Whiplash-Robotics/Whiplash-Aimbot/README.md

# Whiplash - real life aim machine

<div align="center">



</div>

**Status:** Very heavily under construction 🚧  
**Start Date:** December 1, 2024
**Last Updated:** March 31, 2025

## **Our Vision**

This project is an ambitious undertaking to create a _real-life aim machine_—a physical device that moves a mouse to click on targets as quickly and accurately as possible. We aim to push the boundaries of hardware, software, and real-time interaction with a custom-built system.

### **Goals**

1. **Develop Our Own Game**  
   A game designed specifically to challenge and evaluate the capabilities of the aim machine.
2. **Assemble Custom Hardware**  
   Build a physical setup capable of precise and rapid movements to replicate human mouse control.
3. **Implement Computer Vision**  
   Create algorithms to detect and track game elements in real-time.
4. **Write Control Software**  
   Design software to integrate the hardware, computer vision, and game logic seamlessly.

### **Current Progress**

The project is in its very early stages, with planning, research, and initial prototyping underway.

## **Contributors**

A huge thanks to everyone involved in this project!

- [Ryan Zhu](https://github.com/Juno9170) – Project lead &rarr; all-around wizard 🧙‍♂️
- [Daniel Lu](https://github.com/FinityFly) - Computer vision &rarr; hehehehaw 🐷
- [Uros Petrovic](https://github.com/Crooder1) – R&D hardware &rarr; super genius 🧠
- [Puneet Singh](https://github.com/punz1738) – 3D Design & Software developer &rarr; the spearhead 💪
- [Edward Zhang](https://github.com/edwardzhang00) - Game Developer, R&D Software &rarr; our backbone 🪨

## Learnings

For more detailed learnings, refer to [LEARNINGS.md](LEARNINGS.md).

## Tech Stack

- Language: Placeholder for programming language
- Framework: Fumadocs in Next for Documentation, Placeholder for framework
- Tools: Placeholder for tools
- Libraries: Placeholder for libraries
- Other: Placeholder for other technologies
