Whiplash-Robotics/Whiplash-Aimbot/documentation/content/docs/assets/OBJs.mdx

---
title: OBJ Files
description: Downloadable OBJ files for the project
---

## OBJ Files

Below is a list of downloadable OBJ files for various components of the project:

<ul>
  <li><a href="path/to/belt-tensioner.obj" download>Belt Tensioner</a></li>
  <li><a href="path/to/pulley.obj" download>Pulley</a></li>
  <li><a href="path/to/frame.obj" download>Frame</a></li>
</ul>
