Whiplash-Robotics/Whiplash-Aimbot/documentation/content/docs/assets/STLs.mdx

---
title: STL Files
description: Downloadable STL files for the project
---

## STL Files

Below is a list of downloadable STL files for various components of the project:

<ul>
  <li><a href="path/to/belt-tensioner.stl" download>Belt Tensioner</a></li>
  <li><a href="path/to/pulley.stl" download>Pulley</a></li>
  <li><a href="path/to/frame.stl" download>Frame</a></li>
</ul>
