Whiplash-Robotics/Whiplash-Aimbot/control/outputs/graph/out_20250601_153231_rpm_graph.png

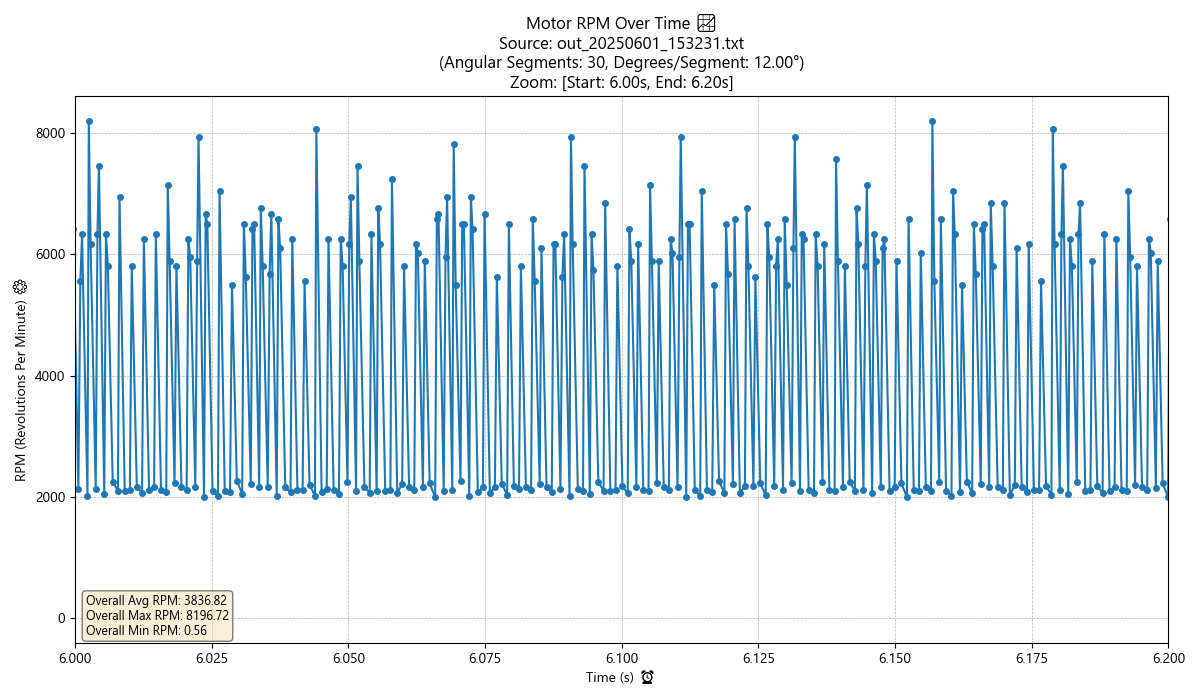
control/outputs/graph/out_20250601_153231_rpm_graph.png
