Whiplash-Robotics/Whiplash-Aimbot/control/outputs/graph/out_20250601_154959_rpm_graph.png

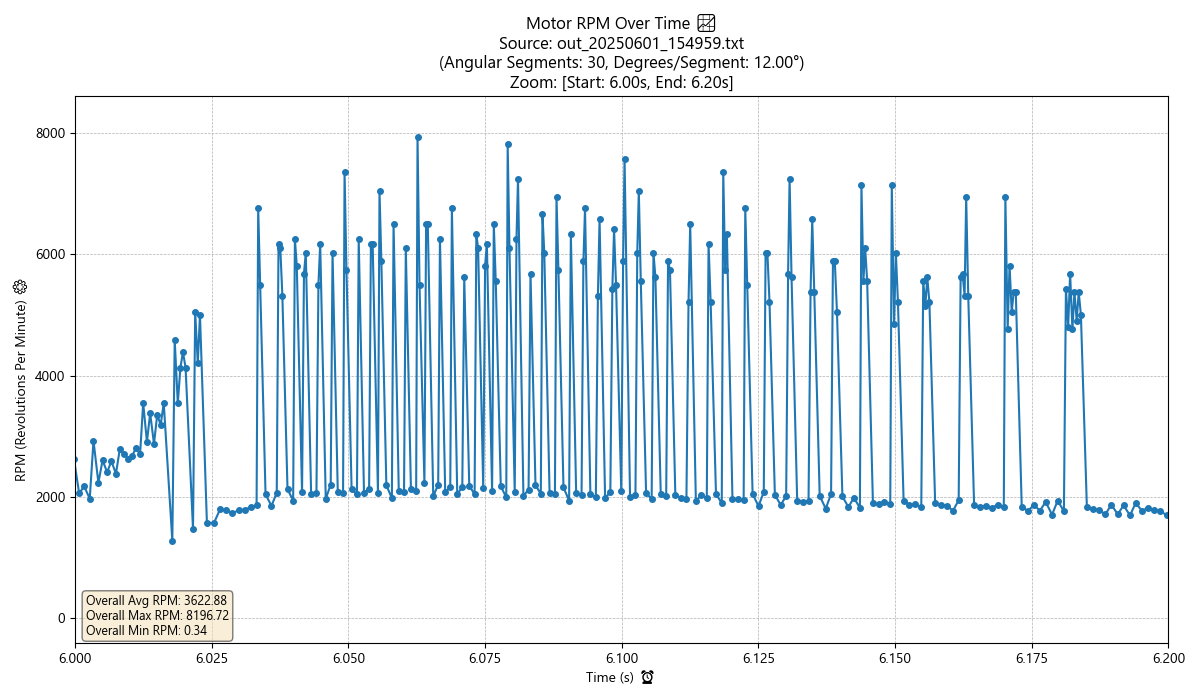
control/outputs/graph/out_20250601_154959_rpm_graph.png
