Whiplash-Robotics/Whiplash-Aimbot/documentation/content/docs/research-development-hardware/electronic-parts/motor-controller.mdx

---
title: Motor Controller
description: "Updated: March 25, 2025"
---

# Overview

## Specifications

Our motor controller needs to be able to handle the voltage and current from our power supply, as well as output it in a predictable and useful way to our motors. The requirements for the motor controller are as follows:
| **Metric** | **Requirements** |
| --- | --- |
| **Voltage**  | 24V |
| **Current**  | 20A |
| **PWM** | Yes |
| **Brushed**  | Yes |
| **Motors** | 1 |

## Options

### SZEKS 

- Price: ~$2-3 on [AliExpress](https://www.aliexpress.com/item/1005001838938266.html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)

| **Metric** | **Specifications** |
| --- | --- |
| **Voltage**  | 10-60V |
| **Current**  | 20A |
| **PWM** | Yes |
| **Brushed**  | Yes |
| **Motors** | 1 |

| **Pros** | **Cons** |
| - | - |
| Cheap | Knob For Voltage |
| Extra Voltage |  |

---

### occkic

- Price: ~$7-15 [AliExpress](https://www.aliexpress.com/item/1005006202680585.html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)

| **Metric** | **Specifications** |
| --- | --- |
| **Voltage**  | 10-50V |
| **Current**  | 20A |
| **PWM** | Yes |
| **Brushed**  | Yes |
| **Motors** | 1 |

| **Pros** | **Cons** |
| - | - |
| Extra Voltage | Relatively Expensive |
|  | Knob For Voltage |
|  | Built For Car Motor |

---

### KOQZM

- Price: ~$1-9 [AliExpress](https://www.aliexpress.com/item/1005006458708033.html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)

| **Metric** | **Specifications** |
| --- | --- |
| **Voltage**  | 10-60V |
| **Current**  | 20A |
| **PWM** | Yes |
| **Brushed**  | Yes |
| **Motors** | 1 |

| **Pros** | **Cons** |
| - | - |
| Really Cheap | Cheap With High Discount |
| Knob Soldered Directly On |  |
| Extra Voltage |  |
| Higher Quantity Sold | |

---

### SHANGSIMOUDLECX

- Price: ~$10 [AliExpress](https://vi.aliexpress.com/item/1005006315810942.html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)

| **Metric** | **Specifications** |
| --- | --- |
| **Voltage**  | 10-50V |
| **Current**  | 20A |
| **PWM** | Yes |
| **Brushed**  | Yes |
| **Motors** | 1 |

| **Pros** | **Cons** |
| - | - |
| Built For Arduino | Relatively Expensive |
| Extra Voltage | Knob For Voltage |
| Higher Quantity Sold | |

## Summary

| Motor Controller | Voltage | Current | PWM | Brushed | Motors | Price  |
| --- | --- | --- | --- | --- | --- | --- |
| SZEKS | 10-60V  | 20A | Yes | Yes | 1 | ~$2-3  |
| occkic | 10-50V  | 20A | Yes | Yes | 1 | ~$7-15 |
| KOQZM | 10-60V  | 20A | Yes | Yes | 1 | ~$1-9  |
| SHANGSIMOUDLECX  | 10-50V  | 20A | Yes | Yes | 1 | ~$10 |

## Choice

After going through the options, we decided on the **KOQZM** because it meets all of our requirements at a very low price. 
The **KOQZM** also has a high rating (4.5/5) and a good amount of reviews (11), which gives us confidence in our purchase.
