Whiplash-Robotics/Whiplash-Aimbot/documentation/content/docs/research-development-hardware/printing/printer.mdx

---
title: Printer
description: "Updated: December 6, 2024 "
---

# Options

### Neptune 3 Pro

- Price: $217.99
- Brand: Elegoo

  | **Pros**                         | **Cons**               |
  | -------------------------------- | ---------------------- |
  | Cheap                            | Sub-par print speeds   |
  | Reliable, good community support | Requires manual tuning |
  | User/begginer friendly           | Sub-par max print size |
  | "Auto" bed leveling              |                        |

---

### Neptune 3 Plus

- Price: $327.99
- Brand: Elegoo

  | **Pros**               | **Cons**         |
  | ---------------------- | ---------------- |
  | Same as the Pro        | Large print size |
  | Very good reviews      |                  |
  | Requires minimal setup |                  |

---

### Ender-3 V3 SE

- Price: $199.00
- Brand: Creality

  | **Pros**          | **Cons**               |
  | ----------------- | ---------------------- |
  | Very Cheap        | Sub-par print speeds   |
  | Good reliablility | Low nozzle temperature |
  |                   | Requires setup         |

---

### A1 Mini

- Price: $249.00
- Brand: Elegoo

  | **Pros**                 | **Cons**   |
  | ------------------------ | ---------- |
  | Not too expensive        | Very small |
  | Perfect reliablility     |            |
  | Extremely good review    |            |
  | Requires almost no setup |            |
  | Actual auto calibration  |            |
  | Very fast printing       |            |
  | Good temperature         |            |

---

### SuperRacer

- Price: $350.00
- Brand: FLSun

  | **Pros**               | **Cons**                   |
  | ---------------------- | -------------------------- |
  | Good reliablility      | Pricey                     |
  | Requires minimal setup | Not as supported           |
  | Auto Leveling          | Average print size         |
  |                        | Low-ish nozzle temperature |

## Summary

| Printer | Speed (mm/s) | Reliability | Ease of Use | Price (CAD) |
| --- | --- | --- | --- | --- |
| Elegoo Neptune 3 Pro | Up to 180 | High (direct drive, stable frame)  | Easy (auto-leveling, touchscreen) | ~$220 |
| Elegoo Neptune 3 PLUS  | Up to 180 | High (larger print volume, stable) | Easy (auto-leveling, touchscreen) | ~$330 |
| Creality Ender-3 v3 SE | Up to 150 | Moderate (requires tuning) | Moderate (manual leveling, basic UI) | ~$200 |
| Bambu A1 Mini | Up to 250 | Very High (CoreXY, precision) | Very Easy (plug-and-play, AI monitoring) | ~$250 |
| FLsun SuperRacer | Up to 200 | Moderate (Delta design quirks) | Moderate (steep learning curve) | ~$350 |

## Choice

Although we really wanted to go with the **Bambu Labs A1 Mini** because I felt as if this was the best choice in terms of everything especially speed, the small size was a deal breaker.
The final choice is the **Elegoo Neptune 3 Plus**, as this one was the runner up in print experince but offers a much larger printing volume. For future projects, Bambu Labs will be our top choice.
