Whiplash-Robotics/Whiplash-Aimbot/yolo-benchmarking/README.md

# YOLO Benchmarking

## Sources

- v11: https://github.com/ultralytics/ultralytics
- v10: https://docs.ultralytics.com/models/yolov10/#performance
- v8: https://docs.ultralytics.com/models/yolov8/#performance-metrics
- v6: https://github.com/meituan/YOLOv6/releases
- v5: https://github.com/ultralytics/yolov5?tab=readme-ov-file
- DAMO: https://github.com/tinyvision/damo-yolo
