Whiplash-Robotics/Whiplash-Aimbot/(threads)

Thread 9 (2025-02-04):

Timing Belt and Pulley Type >2000mm long, and has to be 10mm wide 10mm inner, 5mm inner

Juno9170, 2025-02-04:
looking at options and length might be issue

https://www.digitmakers.ca/collections/timing-belts/products/gt2-timing-belt-10-mm-width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

https://vi.aliexpress.com/item/1005006322039198.html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

https://vi.aliexpress.com/item/32817328238.html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

https://vi.aliexpress.com/item/1005004000195059.html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

Closed 2025-02-04.

Thread 15 (2025-03-06):

Motor Cage

punz1738, 2025-03-06:
# 3D Printable Motor Cage

## Problem Statement
Designing a 3D-printable motor cage to securely hold motors

## Why It's Important

- Provides a stable and secure mount for the motors, reducing vibrations
- Ensures precise alignment for consistent performance

## Constraints

- Material: PLA+ or whatever is available
- Mounting: Must allow easy installation onto the guide rail system
- Durability: Must withstand repeated movement and potential stress

## Potential Solutions

- Design a 3D-printed cage
- Use heat-press inserts for strong and reusable threaded connections
- Utilize a press-fit design with additional side screws to ensure a secure hold
- Optimize design for easy printing with minimal supports

## Next Steps

- Research existing motor mounts for inspiration
- Create initial CAD models and test fitment
- 3D print prototypes and test for stability, alignment, and durability
- Refine the design based on test results and finalize the model
- Hope for the best

Closed 2025-03-23.

Thread 25 (2025-03-20):

Put Mouse Choice on Docs

Juno9170, 2025-03-20:
# Mouse Selection

## Problem Statement
Selecting an appropriate mouse for use in a mechanical aimbot project.

## Why It's Important
- The mouse will be stripped down to its PCB and barebones to minimize mass.
- A suitable mouse ensures precise and accurate tracking for the aimbot.
- Cost-effectiveness is a key factor to stay within budget.

## Constraints
- Budget: <$50
- Must have a flawless sensor (reference: [[Flawless Sensor List](https://thegamingsetup.com/gaming-mouse/buying-guides/flawless-mouse-sensor-list)](https://thegamingsetup.com/gaming-mouse/buying-guides/flawless-mouse-sensor-list))
- Should be easy to disassemble and modify

## Potential Solutions
- Research and shortlist mice that fit the criteria.
- Compare sensor performance and ease of disassembly.
- Evaluate weight and structural considerations for the modified setup.
- Check on the used market

## Next Steps
- Confirm the sensor type and performance.
- Test teardown feasibility and assess modifications needed.
- Add to Docs
- Finalize selection and proceed with integration into the project.

Closed 2025-03-23.

Thread 26 (2025-03-20):

Figure out motor mount

Juno9170, 2025-03-20:
# Motor Mount Design Improvements

## Problem Statement

The current motor mount design faces structural issues during support removal and printing, leading to component failure.

## Why It's Important

- **Structural Integrity**: Ensuring the motor mount maintains its strength during and after the printing process is crucial for the overall reliability of the project.
- **Print Quality**: Addressing warping and support-related issues will enhance the quality and durability of the printed parts.

## Constraints

- **Material**: PLA filament
- **Printing Conditions**: Standard room temperature with potential drafts
- **Design Specifications**: Must fit existing motor dimensions and mounting points

## Issues Identified

1. **Support Removal Leading to Breakage**: Removing printed supports has caused the legs of the motor mount to snap off.
2. **Warping During Printing**: The motor mount exhibits warping, compromising its dimensional accuracy and structural integrity.

## Potential Solutions

1. **Enhance Structural Support**:
   - **Add Reinforcement**: Introduce an extra ring of support around the legs to distribute stress and prevent breakage during support removal.
   - **Design Modifications**: Implement fillets or chamfers at critical junctions to reduce stress concentrations.

2. **Improve Print Adhesion and Stability**:
   - **Dry Filament**: Ensure the PLA filament is properly dried before printing to reduce moisture-related issues that can lead to warping.
   - **Bed Adhesion Techniques**: Utilize adhesion aids such as brims, rafts, or adhesives (e.g., glue stick) to minimize warping and ensure the print remains anchored to the build plate. :contentReference[oaicite:0]{index=0}
   - **Optimize Print Settings**: Adjust print speed, temperature, and cooling settings to achieve a balance between adhesion and warping prevention.

3. **Support Structure Optimization**:
   - **Custom Support Design**: Design custom supports that are easier to remove and place less stress on delicate features.
   - **Adjust Support Parameters**: Modify support density, pattern, and interface settings to facilitate easier removal without compromising print quality. :contentReference[oaicite:1]{index=1}

## Next Steps

1. **Design Revisions**:
   - Implement the proposed structural reinforcements in the motor mount CAD model.
   - Share the updated design for review and feedback.

2. **Print Preparation**:
   - Dry the PLA filament thoroughly before printing.
   - Clean and prepare the print bed to enhance adhesion.

3. **Test Printing**:
   - Print the revised motor mount design using the optimized settings.
   - Document the printing process, noting any issues or improvements observed.

4. **Evaluation**:
   - Assess the ease of support removal and inspect the motor mount for any signs of warping or structural weakness.
   - Gather feedback and iterate on the design as necessary.

By addressing these issues systematically, we aim to enhance the durability and quality of the motor mount, ensuring its suitability for the intended application.

Closed 2025-03-31.

Thread 36 (2025-03-20):

Integrate project autolabelling

FinityFly, 2025-03-20:
- Implement project autolabelling into Whiplash-Aimbot
   - Automatically changes "Status: " label on issue move in Status board in projects
   - https://github.com/technote-space/auto-card-labeler
   - https://docs.github.com/en/issues/planning-and-tracking-with-projects/automating-your-project

Closed 2025-03-30.

Thread 59 (2025-03-28):

Motor Test Rig

Juno9170, 2025-03-28:
# Motor Testing

## Radial load
- see if the motor is mechanically affected by 100N of radial load from the belt tension

## Current Draw
- measure current and rpm at every load

## Stall torque and current
- Get an upper bound on max output power and torque
-

Closed 2025-06-20.

Thread 60 (2025-03-28):

Get Ball bearings

Juno9170, 2025-03-28:
# Bearings

## specs
- cheap and strong in the radial load
- 4mm inner diam, 10-11mm outer diam

## usage
- pressfit for the X axis guide rail moment translation

Thread 72 (2025-04-04):

r&d(hardware/docs): Magnetic Encoder Research Docs

Juno9170, 2025-04-04:
### Objective

Research and develop a clear idea on how we will measure RPM and displacement from the motors

### Approach

Using a ring of magnets attached to the shaft of the motor and a hall effect sensor to get a clear idea on how the motor is moving in real time

connecting the hall effect sensor to the arduino to get some data

### Additional Context

_No response_

Thread 73 (2025-04-04):

hardware: Magnetic Encoder Design

Juno9170, 2025-04-04:
### Objective

Design a printable ring for the magnetic encoder

### Additional Context

_No response_

Thread 81 (2025-06-20):

hardware(scope): description Design and Test Belt Attachment

Juno9170, 2025-06-20:
### Objective

Somehow figure out a way to securely attach the loose end of the timing belt to the mouse holder.

Metrics to test:
Max Tension Strength
Max Elastic Deformation (Whiplash)

### Additional Context

_No response_
