Whiplash-Robotics/Whiplash-Aimbot/(commit log)

2024-12-08 feat(docs/r&d hardware): 3D Printer Choice
2025-01-06 feat(docs/mech-parts): add guide rail docs and init timing belt docs
2025-01-07 feat(docs/printing): add choice of material
2025-01-08 feat(docs/design): finish belt tensioner
2025-01-08 feat(docs/assets): add STL downloads
2025-01-09 feat(docs/hardware): add motor selection
2025-03-03 chore(docs): refactor motor math equations
2025-03-05 feat(docs): update power supply docs
2025-03-23 feat(docs): update game init, mouse, motor cage docs (#50)
    * feat(docs): add motor cage docs
    * feat(docs): Add Unreal Engine Set Up
    * feat(docs): add details to game initialization
    * feat(docs): start mouse docs
    * feat(docs): update engine choice explanation
    * fix: update details, fix deploy issue
    ---------
2025-03-24 feat (cv): add sample model load
2025-03-26 feat(docs): update timing-belt docs
2025-03-26 chore(docs): fix timing-belt typo
2025-03-26 feat(docs): add motor controller docs
2025-03-26 chore(docs): fix typos in motor controller
2025-05-27 feat(control):add encoder reader v1
2025-06-01 feat(control): add button listener, upgrade encoder reader
2025-06-01 feat(control): add button listeners to encoder listener
2025-06-20 chore(control): fix python linting issues
    [graph.py, log.py]
2025-06-20 chore(control): fix other flake8 issues
    [graph.py, log.py]
